jntaimo/2.12-PCB/2.12 Mobile Robot/2.12 Mobile Robot.step

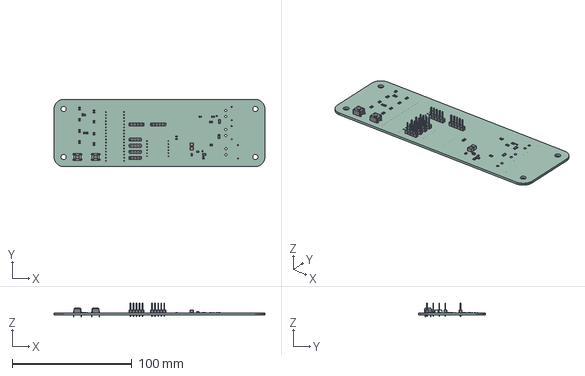
[picture p1: CAD file, 2024-03-19]
2.12 Mobile Robot/2.12 Mobile Robot.step
176.0 x 56.0 x 12.0 mm
PCB
