jntaimo/2.12-PCB/2.12 Mobile Robot/2.12 Mobile Robot.kicad_pcb

## KiCad design 2.12 Mobile Robot/2.12 Mobile Robot.kicad_pcb (2024-08-05)

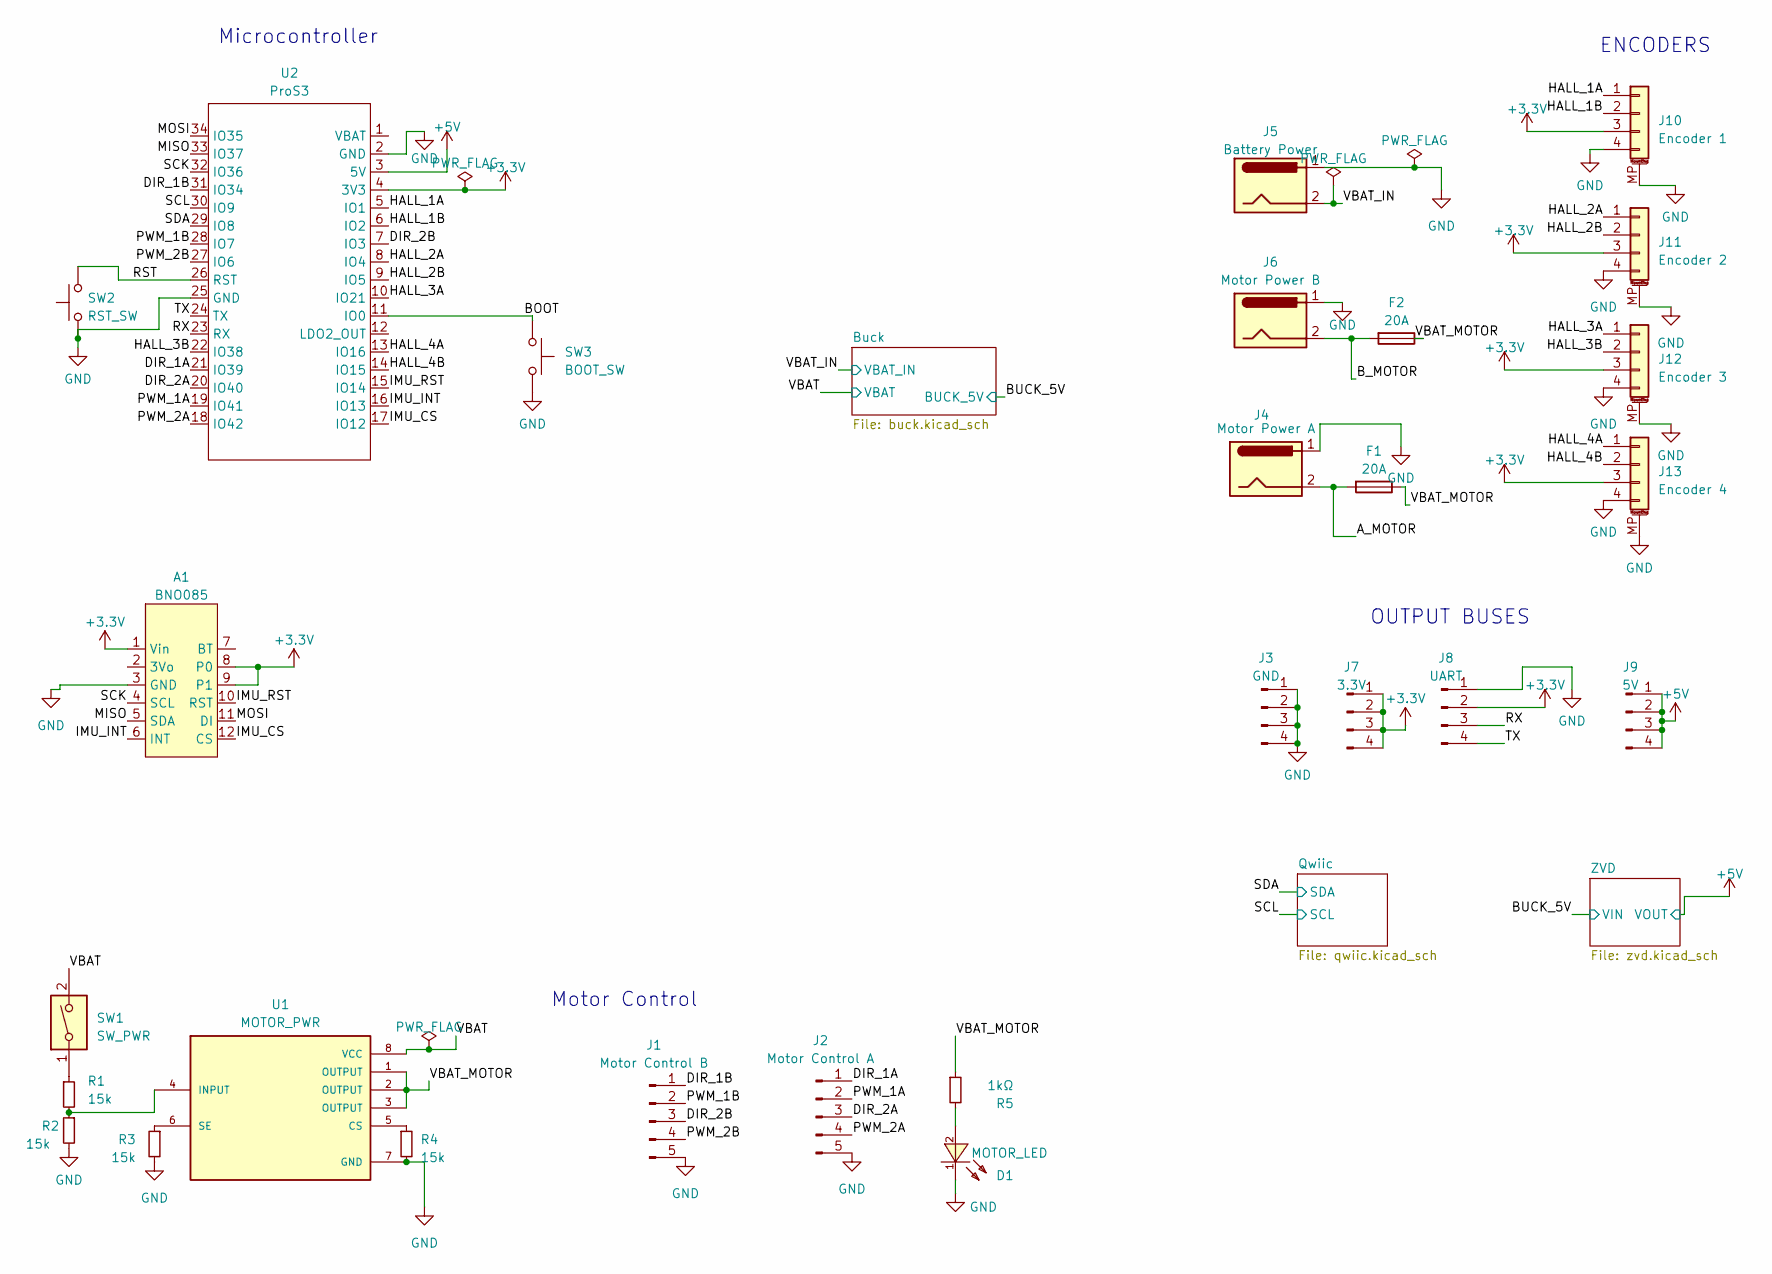
[picture p2: schematic 2.12 Mobile Robot.kicad_sch, 2.12 Mobile Robot PCB]

Parts:
A1: BNO085; Adafruit_BNO085
D1: MOTOR_LED; LED0603; LCSC C2286
F1, F2: 20A; Fuse_1206_3216Metric; MPN C207007
J1: Motor Control B; PinHeader_1x05_P2.54mm_Vertical; MPN C492404
J2: Motor Control A; PinHeader_1x05_P2.54mm_Vertical; MPN C492404
J3: GND; PinHeader_1x04_P2.54mm_Vertical; MPN C2691448
J4: Motor Power A; AMASS_XT30PW-F_1x02_P2.50mm_Horizontal; LCSC C2913282
J5: Battery Power; AMASS_XT30PW-M_1x02_P2.50mm_Horizontal; LCSC C2913282
J6: Motor Power B; AMASS_XT30PW-F_1x02_P2.50mm_Horizontal; LCSC C2913282
J7: 3.3V; PinHeader_1x04_P2.54mm_Vertical; MPN C2691448
J8: UART; PinHeader_1x04_P2.54mm_Vertical; MPN C2691448
J9: 5V; PinHeader_1x04_P2.54mm_Vertical; MPN C2691448
J10: Encoder 1; JST_PH_S4B-PH-SM4-TB_1x04-1MP_P2.00mm_Horizontal; MPN C265102
J11: Encoder 2; JST_PH_S4B-PH-SM4-TB_1x04-1MP_P2.00mm_Horizontal; MPN C265102
J12: Encoder 3; JST_PH_S4B-PH-SM4-TB_1x04-1MP_P2.00mm_Horizontal; MPN C265102
J13: Encoder 4; JST_PH_S4B-PH-SM4-TB_1x04-1MP_P2.00mm_Horizontal; MPN C265102
R1, R2, R3, R4: 15k; 0603_1608Metric; MFGPN 0603WAF1502T5E; LCSC C22809
R5: 1kΩ; 0603_1608Metric; MPN C5555492; LCSC C21190
SW1: SW_PWR; JST_PH_B2B-PH-SM4-TB_1x02-1MP_P2.00mm_Vertical; MPN C160352
SW2: RST_SW; SW_PUSH_6mm; MPN C393938
SW3: BOOT_SW; SW_PUSH_6mm; MPN C393938
U1: MOTOR_PWR; DPAK85P972X240-8N; MPN C2150194
U2: ProS3; ProS3_TH

Connections:
+5V: J9.1, J9.2, J9.3, J9.4, U2.3 (5V); also elsewhere on the board
/A_MOTOR: F1.2, J4.2
/BOOT: SW3.1, U2.11 (IO0)
/B_MOTOR: F2.2, J6.2
/DIR_1A: J2.1, U2.21 (IO39)
/DIR_1B: J1.1, U2.31 (IO34)
/DIR_2A: J2.3, U2.20 (IO40)
/DIR_2B: J1.3, U2.7 (IO3)
/HALL_1A: J10.1, U2.5 (IO1)
/HALL_1B: J10.2, U2.6 (IO2)
/HALL_2A: J11.1, U2.8 (IO4)
/HALL_2B: J11.2, U2.9 (IO5)
/HALL_3A: J12.1, U2.10 (IO21)
/HALL_3B: J12.2, U2.22 (IO38)
/HALL_4A: J13.1, U2.13 (IO16)
/HALL_4B: J13.2, U2.14 (IO15)
/IMU_CS: A1.12 (CS), U2.17 (IO12)
/IMU_INT: A1.6 (INT), U2.16 (IO13)
/IMU_RST: A1.10 (RST), U2.15 (IO14)
/MISO: A1.5 (SDA), U2.33 (IO37)
/MOSI: A1.11 (DI), U2.34 (IO35)
/PWM_1A: J2.2, U2.19 (IO41)
/PWM_1B: J1.2, U2.28 (IO7)
/PWM_2A: J2.4, U2.18 (IO42)
/PWM_2B: J1.4, U2.27 (IO6)
/RST: SW2.2, U2.26 (RST)
/RX: J8.3, U2.23 (RX)
/SCK: A1.4 (SCL), U2.32 (IO36)
/SCL: U2.30 (IO9); also elsewhere on the board
/SDA: U2.29 (IO8); also elsewhere on the board
/TX: J8.4, U2.24 (TX)
/VBAT: SW1.2, U1.8 (VCC); also elsewhere on the board
/VBAT_IN: J5.2; also elsewhere on the board
/VBAT_MOTOR: F1.1, F2.1, R5.1, U1.1 (OUTPUT), U1.2 (OUTPUT), U1.3 (OUTPUT)
GND: A1.3 (GND), D1.1 (K), J1.5, J2.5, J3.1, J3.2, J3.3, J3.4, J4.1, J5.1, J6.1, J8.1, J10.4, J10.MP (MountPin), J11.4, J11.MP (MountPin), J12.4, J12.MP (MountPin), J13.4, J13.MP (MountPin), R2.2, R3.2, R4.2, SW2.1, SW3.2, U1.7 (GND), U2.2 (GND), U2.25 (GND); also elsewhere on the board
unnamed: D1.2 (A), R5.2
unnamed: R1.1, SW1.1
unnamed: R4.1, U1.5 (CS)
unnamed: R1.2, R2.1, U1.4 (INPUT)
unnamed: R3.1, U1.6 (SE)

Notes on the sheet:
OUTPUT BUSES
ENCODERS
Microcontroller
Motor Control

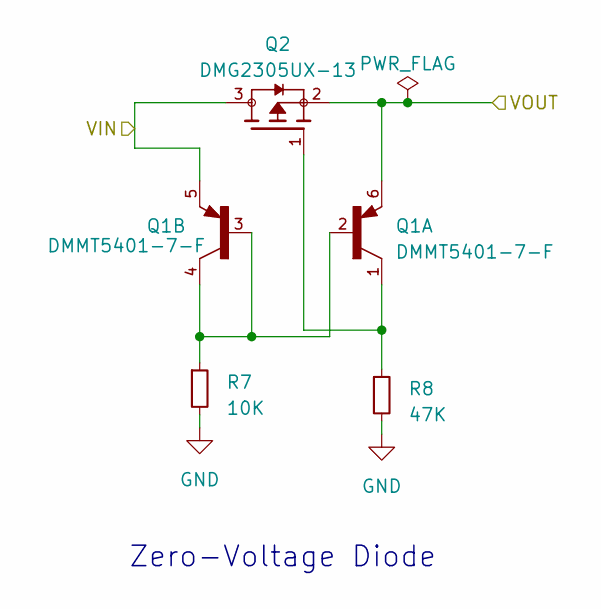
[picture p3: schematic zvd.kicad_sch, Zero Voltage Diode]

Parts:
Q1: DMMT5401-7-F; SOT95P285X140-6N; PARTREV 8
Q2: DMG2305UX-13; SOT91P240X110-3N; PARTREV 09/2018
R7: 10K; 0603_1608Metric; MPN C22548; LCSC C25804
R8: 47K; 0603_1608Metric; MPN C25792; LCSC C25819

Connections:
+5V: Q1.6, Q2.2; also elsewhere on the board
/BUCK_5V: Q1.5, Q2.3; also elsewhere on the board

Notes on the sheet:
Zero-Voltage Diode

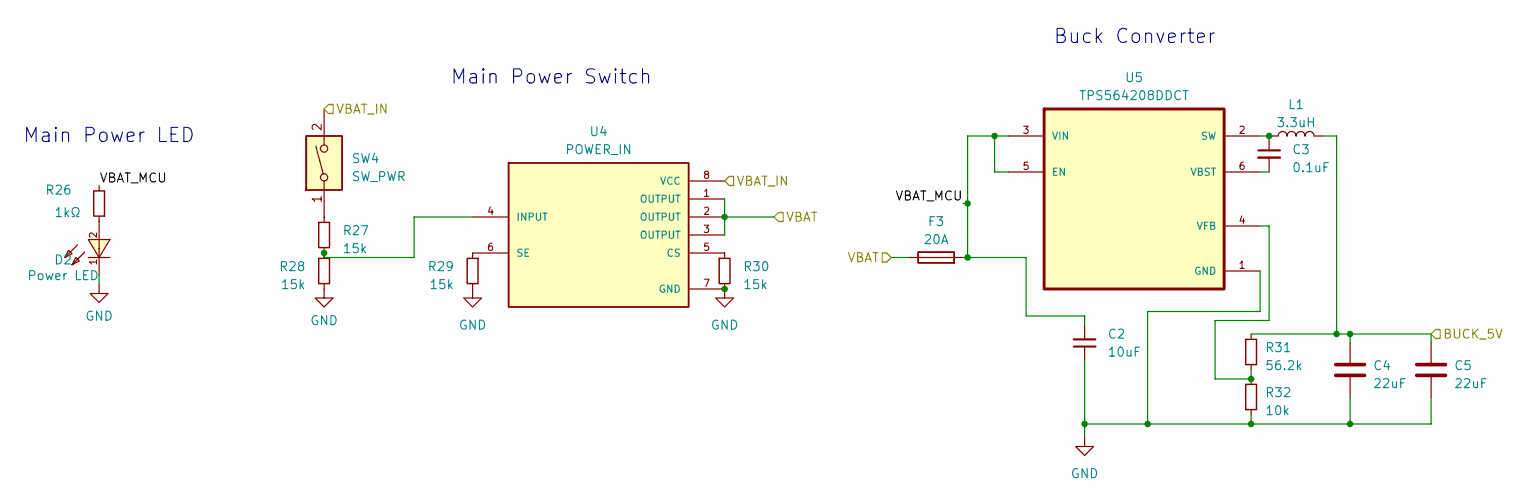
[picture p4: schematic buck.kicad_sch, Buck Converter]

Parts:
C2: 10uF; 0805_2012Metric; MPN C39232; LCSC C15850
C3: 0.1uF; C_0805_2012Metric; MPN C519981
C4, C5: 22uF; C_1210_3225Metric; MPN C65428
D2: Power LED; LED0603; MPN C84263; LCSC C72043
F3: 20A; Fuse_1206_3216Metric; MPN C207007
L1: 3.3uH; L_Vishay_IHLP-4040; MPN C845075
R26: 1kΩ; 0603_1608Metric; MPN C5555492; LCSC C21190
R27, R28, R29, R30: 15k; 0603_1608Metric; MFGPN 0603WAF1502T5E; LCSC C22809
R31: 56.2k; 0603_1608Metric; MFGPN RC0603FR-0756K2L; LCSC C482887
R32: 10k; 0603_1608Metric; MPN C22548; LCSC C25804
SW4: SW_PWR; JST_PH_B2B-PH-SM4-TB_1x02-1MP_P2.00mm_Vertical; MPN C160352
U4: POWER_IN; DPAK85P972X240-8N; MPN C2150194
U5: TPS564208DDCT; SOT95P280X110-6N; MPN C2070774

Connections:
/BUCK_5V: C4.1, C5.1, L1.2, R31.1; also elsewhere on the board
/Buck/VBAT_MCU: C2.1, F3.2, R26.2, U5.3 (VIN), U5.5 (EN)
/VBAT: F3.1, U4.1 (OUTPUT), U4.2 (OUTPUT), U4.3 (OUTPUT); also elsewhere on the board
/VBAT_IN: SW4.2, U4.8 (VCC); also elsewhere on the board
GND: C2.2, C4.2, C5.2, D2.1 (C), R28.2, R29.2, R30.2, R32.2, U4.7 (GND), U5.1 (GND); also elsewhere on the board
unnamed: D2.2 (A), R26.1
unnamed: R27.1, SW4.1
unnamed: R30.1, U4.5 (CS)
unnamed: R27.2, R28.1, U4.4 (INPUT)
unnamed: R29.1, U4.6 (SE)
unnamed: C3.1, L1.1, U5.2 (SW)
unnamed: C3.2, U5.6 (VBST)
unnamed: R31.2, R32.1, U5.4 (VFB)

Notes on the sheet:
Main Power Switch
Main Power LED
Buck Converter

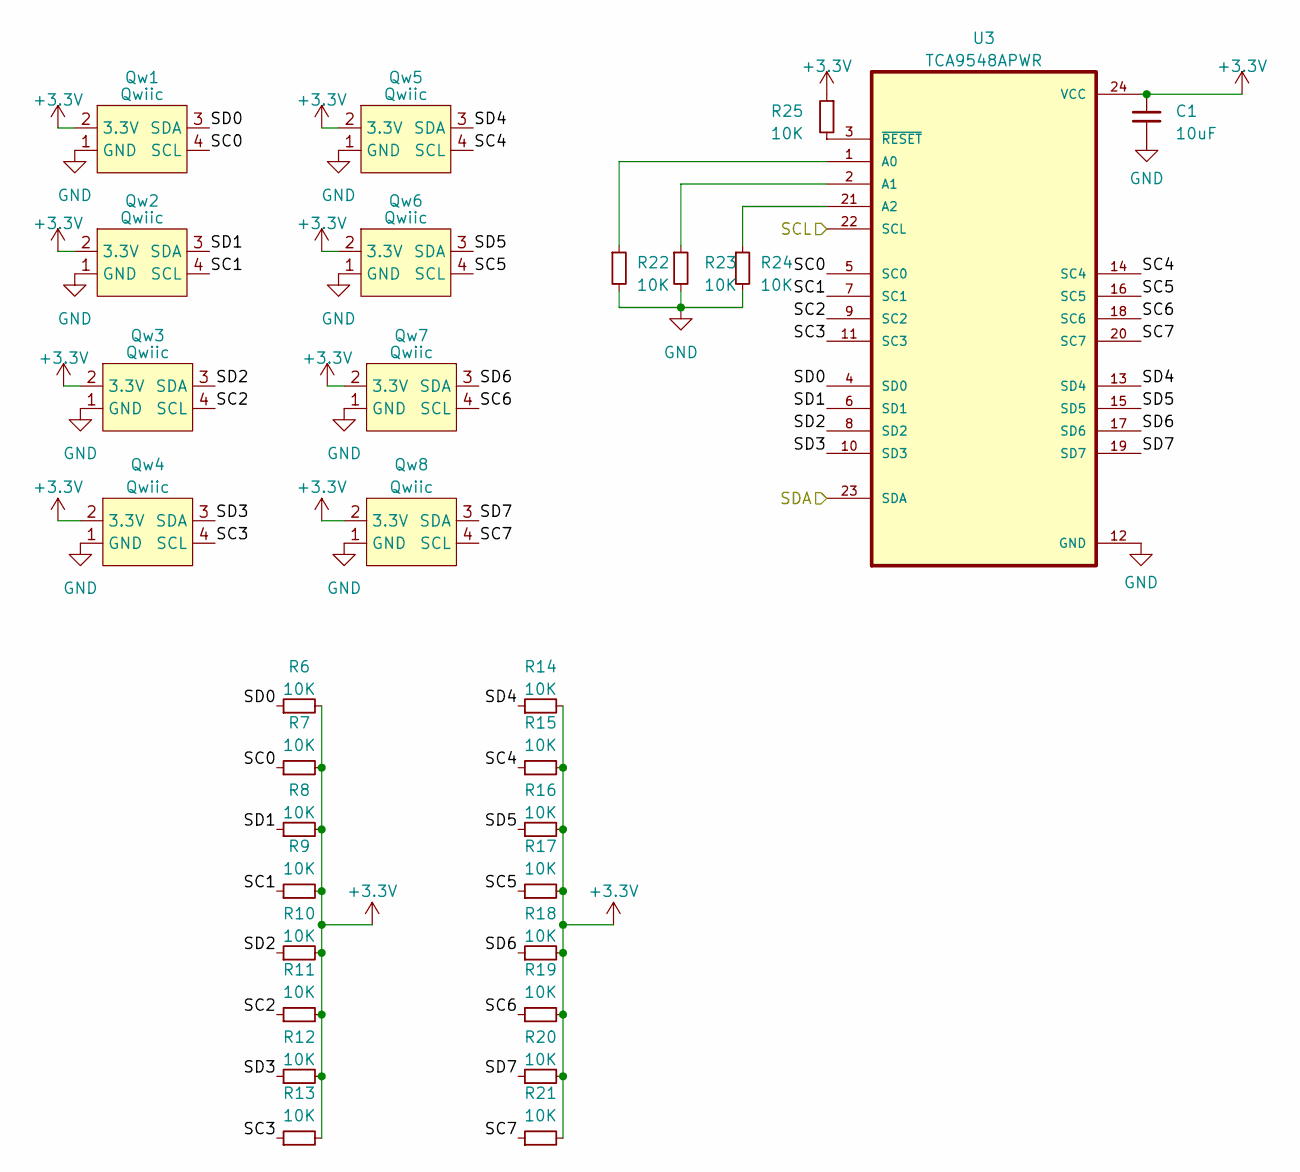
[picture p5: schematic qwiic.kicad_sch, I2C Multiplexer]

Parts:
C1: 10uF; 0805_2012Metric; MPN C39232; LCSC C15850
Qw1, Qw2, Qw3, Qw4, Qw5, Qw6, Qw7, Qw8: Qwiic; JST_SH_BM04B-SRSS-TB_1x04-1MP_P1.00mm_Vertical; MPN C160390
R6, R7, R8, R9, R10, R11, R12, R13, R14, R15, R16, R17, R18, R19, R20, R21, R22, R23, R24, R25: 10K; 0603_1608Metric; MPN C22548; LCSC C25804
U3: TCA9548APWR; SOP65P640X120-24N; MPN C130026

Connections:
/Qwiic/SC1: Qw2.4 (SCL), R9.1, U3.7 (SC1)
/Qwiic/SC2: Qw3.4 (SCL), R11.1, U3.9 (SC2)
/Qwiic/SC3: Qw4.4 (SCL), R13.1, U3.11 (SC3)
/Qwiic/SC4: Qw5.4 (SCL), R15.1, U3.14 (SC4)
/Qwiic/SC5: Qw6.4 (SCL), R17.1, U3.16 (SC5)
/Qwiic/SC6: Qw7.4 (SCL), R19.1, U3.18 (SC6)
/Qwiic/SC7: Qw8.4 (SCL), R21.1, U3.20 (SC7)
/Qwiic/SD0: Qw1.3 (SDA), R6.1, U3.4 (SD0)
/Qwiic/SD2: Qw3.3 (SDA), R10.1, U3.8 (SD2)
/Qwiic/SD3: Qw4.3 (SDA), R12.1, U3.10 (SD3)
/Qwiic/SD4: Qw5.3 (SDA), R14.1, U3.13 (SD4)
/Qwiic/SD5: Qw6.3 (SDA), R16.1, U3.15 (SD5)
/Qwiic/SD6: Qw7.3 (SDA), R18.1, U3.17 (SD6)
/Qwiic/SD7: Qw8.3 (SDA), R20.1, U3.19 (SD7)
/SCL: U3.22 (SCL); also elsewhere on the board
/SDA: U3.23 (SDA); also elsewhere on the board
GND: C1.2, Qw1.1 (GND), Qw2.1 (GND), Qw3.1 (GND), Qw4.1 (GND), Qw5.1 (GND), Qw6.1 (GND), Qw7.1 (GND), Qw8.1 (GND), R22.2, R23.2, R24.2, U3.12 (GND); also elsewhere on the board
unnamed: R22.1, U3.1 (A0)
unnamed: R23.1, U3.2 (A1)
unnamed: R24.1, U3.21 (A2)
unnamed: R25.2, U3.3 (~RESET)

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
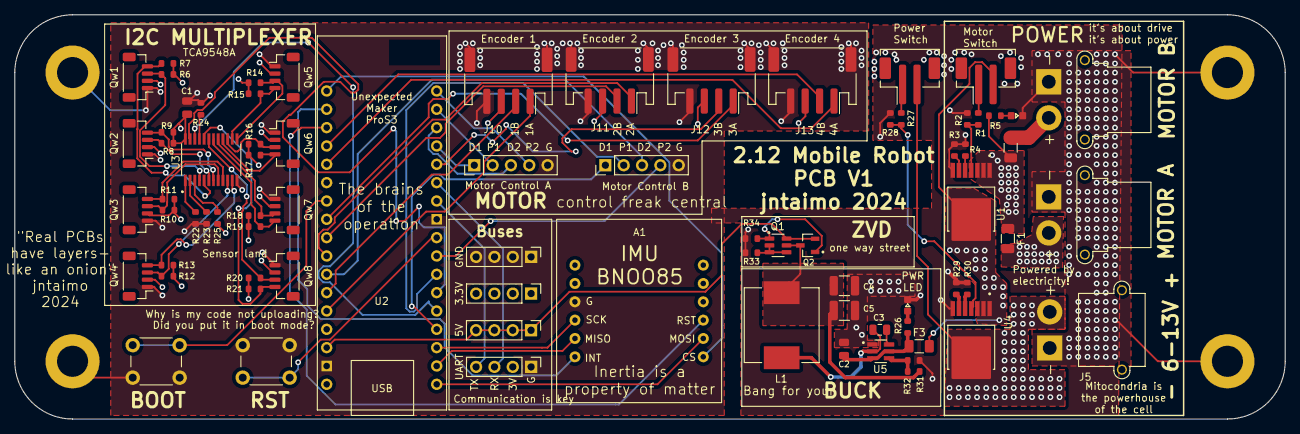
[picture p6: board 2.12 Mobile Robot.kicad_pcb from above]

Board: 4 copper layers, 176.0 x 56.0 mm, 78 parts (0 on the bottom side), 73 nets.

Other parts of the board:
R33: 10K; 0603_1608Metric
R34: 47K; 0603_1608Metric

Their connections:
GND: R33.2, R34.2; also elsewhere on the board
