jntaimo/2.12-PCB/(commit log)

2024-01-26 Intial commit
    [2.12 Mobile Robot.kicad_pcb, 2.12 Mobile Robot.kicad_sch]
2024-01-30 Added hierarchical sheets
    [2.12 Mobile Robot.kicad_sch, buck.kicad_sch, qwiic.kicad_sch, zvd.kicad_sch]
2024-01-30 Passed DRC
    [2.12 Mobile Robot.kicad_sch, buck.kicad_sch, qwiic.kicad_sch]
2024-02-03 Changed some of the footprints
    [buck.kicad_sch, qwiic.kicad_sch]
2024-02-12 Renamed stuff
    [2.12 Mobile Robot.kicad_pcb, qwiic.kicad_sch, zvd.kicad_sch]
2024-02-16 Fully routed
    [2.12 Mobile Robot.kicad_pcb, 2.12 Mobile Robot.kicad_sch, buck.kicad_sch, qwiic.kicad_sch, zvd.kicad_sch]
2024-02-16 Made footprints from project libraries
    [2.12 Mobile Robot.kicad_pcb, 2.12 Mobile Robot.kicad_sch, buck.kicad_sch, qwiic.kicad_sch, zvd.kicad_sch]
2024-02-17 Added silkscreen callouts and fixed resistors
    [2.12 Mobile Robot.kicad_pcb, 2.12 Mobile Robot.kicad_sch, buck.kicad_sch, qwiic.kicad_sch, zvd.kicad_sch]
2024-02-17 Fixed thermal reliefs on pour
    [2.12 Mobile Robot.kicad_pcb]
2024-02-18 About to add JLCPCB libraries
    [2.12 Mobile Robot.kicad_pcb, 2.12 Mobile Robot.kicad_sch]
2024-02-19 Tentatively ready for production
    [2.12 Mobile Robot.kicad_pcb, 2.12 Mobile Robot.kicad_sch, bom.csv, buck.kicad_sch, designators.csv, positions.csv, qwiic.kicad_sch, zvd.kicad_sch]
2024-02-20 Production files
    [2.12 Mobile Robot.kicad_pcb, bom.csv, designators.csv, positions.csv]
2024-02-24 Updated silkscreen to be generic
    [2.12 Mobile Robot.kicad_pcb, 2.12 Mobile Robot.kicad_sch, bom.csv, designators.csv, positions.csv]
2024-02-24 fixed silkscreen error
    [2.12 Mobile Robot.kicad_pcb, bom.csv, designators.csv, positions.csv]
2024-08-05 Updated to Kicad 8
    [2.12 Mobile Robot.kicad_pcb, 2.12 Mobile Robot.kicad_sch, buck.kicad_sch, qwiic.kicad_sch, zvd.kicad_sch]
